johnschimmel/UnoJoy-w-BT-SoftwareSerial/(commit log)

2014-12-05 unojoy arduino with bluetooth mate on software serial
2014-12-08 new button library working
2014-12-10 update switches
2014-12-10 turning off a few switches
2015-01-31 all switches working
2015-02-16 reversed switch button order
    [UnoJoyArduino.ino]
2016-10-24 flow image included
